shenxn/cse237a-wi20-roomsign/arduino/roomsign/roomsign.ino

#include <SPI.h>
#include <avr/power.h>
#include "epdif.h"
#include "radio.h"
#include "epaper.h"
#include "status.h"
#include "rfid.h"
#include "servo.h"
#include "macro.h"
#include "sleep.h"

void setup() {
#ifdef DEBUG
    Serial.begin(115200);
    Serial.println(F("starting"));
#endif

    // turn off not used things
    ADCSRA = 0;  // disable ADC
    power_adc_disable();
    power_twi_disable();

    // set all SS pins to high to prevent SPI conflict
    pinMode(RFID_SS_PIN, OUTPUT);
    digitalWrite(RFID_SS_PIN, HIGH);
    pinMode(CS_PIN, OUTPUT);  // epaper
    digitalWrite(CS_PIN, HIGH);
    pinMode(RADIO_CSN_PIN, OUTPUT);
    digitalWrite(RADIO_CSN_PIN, HIGH);

    SERIAL_PRINTLN(F("setup rfid"));
    rfidInit();

    SERIAL_PRINTLN(F("setup servo"));
    servoSetup();

    SERIAL_PRINTLN(F("setup epaper"));
    epaperSetup();

    // should be after epaper
    SERIAL_PRINTLN(F("setup radio"));
    radioConfigure();

    // reset clock
    status.clock = 0;
}

void loop() {
    ++status.clock;
    if (status.clock % RADIO_CHECK_INTERVAL == 0) {
        radioFetch();
    }
    rfidRead();
    servoUnlock();
#ifdef SLEEP
    sleep();
#else
    delay(1000);
#endif
}
