shenxn/cse237a-wi20-roomsign/rpi/bridge.py

import traceback
import asyncio
import aiohttp
import json
import time
from apscheduler.schedulers.asyncio import AsyncIOScheduler
from datetime import datetime
from datetime import timedelta
from RF24 import *
import RPi.GPIO as GPIO
import secret
from users import users

CE_PIN = 22
CSN_PIN = 0
IRQ_PIN = 23

tx_pipe = 0xF0F0F0F0E1
rx_pipe = 0xF0F0F0F0D2
payload_size = 32

server = 'https://cse237a-wi20-roomsign.sxn.dev/websocket'
summary_length = 16
creator_length = 17

class Event:
    def __init__(self, raw_event):
        self.start = datetime.fromisoformat(raw_event['start']['dateTime'])
        self.end = datetime.fromisoformat(raw_event['end']['dateTime'])

        # remove tzinfo
        self.start = self.start.replace(tzinfo=None)
        self.end = self.end.replace(tzinfo=None)

        if 'summary' in raw_event:
            self.summary = raw_event['summary']
        else:
            self.summary = '(No title)'

        self.creator = raw_event['creator']['email']


class Radio:
    def __init__(self):
        self.radio = RF24(CE_PIN, CSN_PIN, BCM2835_SPI_SPEED_8MHZ)
        self.payload = None
        self.payload_sent = False

    def init(self):
        print('initializing RF24')
        self.radio.begin()
        # self.radio.setDataRate(RF24_250KBPS)
        self.radio.setAutoAck(1)
        self.radio.setRetries(5, 15)
        self.radio.enableDynamicPayloads()
        self.radio.openWritingPipe(tx_pipe)
        self.radio.openReadingPipe(1, rx_pipe)

        # setup interrupt
        self.radio.maskIRQ(True, True, False)
        GPIO.setmode(GPIO.BCM)
        GPIO.setup(IRQ_PIN, GPIO.IN, pull_up_down=GPIO.PUD_UP)
        GPIO.add_event_detect(IRQ_PIN, GPIO.FALLING, callback=self.interrupt_handler)

        self.radio.printDetails()
        self.radio.startListening()

    def interrupt_handler(self, channel=0):
        while self.radio.available():
            print('interrupt')
            command = self.radio.read(1)
            if command[0] == 0:
                self.send_payload()
            else:
                print('unknown command', command[0])

    def send_payload(self):
        if self.payload is None:
            return
        print('send data')
        self.payload_sent = False  # only one success is needed
        count = 0
        while not self.payload_sent and count < 5:
            self.radio.stopListening()
            if self.radio.write(self.payload):
                self.payload_sent = True
            else:
                print('failed')
                self.payload_sent = False
                self.radio.startListening()  # open for interrupts
                count += 1
                time.sleep(1)  # retry after 1 second
        if self.payload_sent:
            print('\tok')
        else:
            print('\tgive up')
        self.radio.startListening()

    def int_to_bits(self, v, length):
        bits = []
        for i in range(length):
            bits.append(v % 2)
            v //= 2
        bits.reverse()
        return bits

    def str_to_bits(self, s, length):
        bits = []
        for c in s[:length]:
            asc = ord(c)
            if asc >= 48 and asc <= 57:  # 0-9
                v = asc - 48 + 2
            elif asc >= 65 and asc <= 90:  # A-Z
                v = asc - 65 + 2 + 10
            elif asc >= 97 and asc <= 122:  # a-z
                v = asc - 97 + 2 + 10 + 26
            else:  # space or other (treated as space)
                v = 1
            bits += self.int_to_bits(v, 6)
        if len(s) < length:
            bits += [0] * 6 * (length - len(s))
        return bits

    def time_to_bits(self, event):
        start = event.start.hour * 60 + event.start.minute
        end = event.end.hour * 60 + event.end.minute
        return self.int_to_bits(start, 11) + self.int_to_bits(end, 11)

    def bytes_to_bits(self, byte_arr):
        bits = []
        for i in byte_arr:
            bits += self.int_to_bits(i, 8)
        return bits  

    def gen_payload(self, event):
        if event is None:
            bits = [1]
        else:
            bits = [0]
            bits += self.str_to_bits(event.summary, summary_length)
            bits += self.time_to_bits(event)
            if event.creator in users:
                bits += self.str_to_bits(users[event.creator]['name'], creator_length)
                bits += self.bytes_to_bits(users[event.creator]['key_id'])
        if len(bits) < 256:
            bits += [0] * (256 - len(bits))
        payload = []
        for i in range(0, 256, 8):
            b = 0
            for j in range(8):
                b = b * 2 + bits[i + j]
            payload.append(b)
        print('new data ({} bytes)'.format(len(payload)), payload)
        self.payload = bytes(payload)


class Bridge:
    def __init__(self):
        self.events = []
        self.curr_event = None
        self.initialized = False

        self.events_lock = asyncio.Lock()

        self.radio = Radio()

        self.scheduler = AsyncIOScheduler()
        self.scheduler.start()
        self.scheduler_job = None

    def compare_events(self, e1, e2):
        if e1 is None and e2 is None:
            return True
        if e1 is None or e2 is None:
            return False
        return e1.start == e2.start and e1.end == e2.end and e1.summary == e2.summary and e1.creator == e2.creator

    async def job_handler(self):
        self.scheduler_job = None
        await self.update_curr_event()

    async def update_curr_event(self):
        async with self.events_lock:
            now = datetime.now()
            new_curr_event = None
            next_event_time = None
            for event in self.events:
                if event.start > now:
                    next_event_time = event.start
                    break
                if event.end >= now:
                    new_curr_event = event
                    next_event_time = event.end
                    break
            if not self.initialized or not self.compare_events(self.curr_event, new_curr_event):
                if not self.initialized:
                    self.initialized = True
                    self.radio.init()
                self.curr_event = new_curr_event
                print('curr_event updated')
                self.radio.gen_payload(self.curr_event)
            if self.scheduler_job is not None:
                self.scheduler_job.remove()
                self.scheduler_job = None
            if next_event_time is not None:
                self.scheduler_job = self.scheduler.add_job(self.job_handler, 'date', run_date=next_event_time)   


    async def parse_events(self, raw_events):
        async with self.events_lock:
            # parse events
            self.events = []
            for raw_event in raw_events:
                self.events.append(Event(raw_event))
        await self.update_curr_event()



    async def client(self):
        try:
            session = aiohttp.ClientSession()
            async with session.ws_connect(
                url=server,
                headers={'Authorization': 'Bearer ' + secret.WS_TOKEN}) as ws:

                async for msg in ws:
                    if msg.type == aiohttp.WSMsgType.ERROR:
                        print('ws connection closed with exception', ws.exception())
                        break
                    elif msg.type == aiohttp.WSMsgType.TEXT:
                        raw_events = json.loads(msg.data)
                        print('new data received')
                        await self.parse_events(raw_events)
            await session.close()
        except Exception as e:
            traceback.print_tb(e.__traceback__)
            print(e)


    def main(self):
        while True:
            asyncio.get_event_loop().run_until_complete(self.client())
            print('retry in 10s')
            time.sleep(10)


if __name__ == '__main__':
    Bridge().main()
