shenxn/cse237a-wi20-roomsign/arduino/roomsign/radio.h

#ifndef RADIO_H
#define RADIO_H

#define RADIO_CE_PIN A0
#define RADIO_CSN_PIN A1
#define RADIO_IRQ_PIN 2
#define WAITING_TIMEOUT 5000
#define RADIO_CHECK_INTERVAL 10

void radioConfigure();
void radioFetch();
void radioRead();

#endif
