shenxn/cse237a-wi20-roomsign/rpi/users.py

users = {
    'shenxn.io@gmail.com': {
        'name': 'gmail user',
        'key_id': [0x89, 0x7F, 0x97, 0xD5]
    },
    'xis079@eng.ucsd.edu': {
        'name': 'UCSD user',
        'key_id': [0xB7, 0x08, 0x7B, 0x44]
    }
}
