shenxn/cse237a-wi20-roomsign/(commit log)

2020-02-25 Use interrupt on rpi side
2020-02-25 Add RFID and servo functions into main arduino sketchbook
2020-02-26 Replace RF24Network with ack
    [bridge.py, radio.cpp]
2020-02-27 Split RFID and servo onto another board
2020-02-27 Fix bugs (ws connection and servo time overflow)
    [bridge.py, rfid.cpp, servo.cpp, status.h]
2020-02-27 Fix bridge scheduler bug
    [bridge.py]
2020-02-27 Minor fix and cleanup
    [bridge.py, epaper.cpp, rfid.cpp, servo.cpp, servo.h, status.h]
2020-02-28 Use radio interrupt
2020-03-01 Switch to larger screen
2020-03-02 Fix log timestamp error
    [bridge.py]
